SethHibpshman/EWU-ASME-SDC-2026-Robot/firmware/ASME_v2/README.txt

# ASME Coding Project Version 2.0

v2.0 utilizes the full 180degs that the servos offer. Previous version only got ~90degs of movement.
