SethHibpshman/EWU-ASME-SDC-2026-Robot/firmware/ASME_v3/README.txt

# ASME Coding Project Version 2.0

Adds ESC motor functionality. Signal on channel 3 on transmitter, D12 on the Arduino.
