SethHibpshman/EWU-ASME-SDC-2026-Robot/firmware/ASME_v8/README.txt

SW works for gripper shoulder, but turns too far.
gripper hand is always closed and doesnt change
