SethHibpshman/EWU-ASME-SDC-2026-Robot/assets/fig09-steering-radius.png

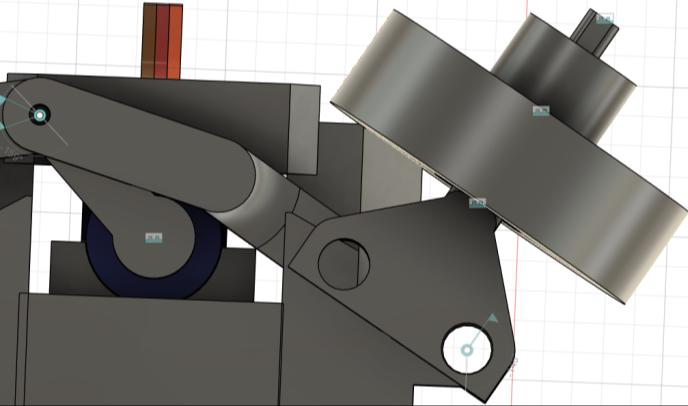
assets/fig09-steering-radius.png
