SethHibpshman/EWU-ASME-SDC-2026-Robot/hardware/PCB KiCAD/File Exports/ASME-eFest.step

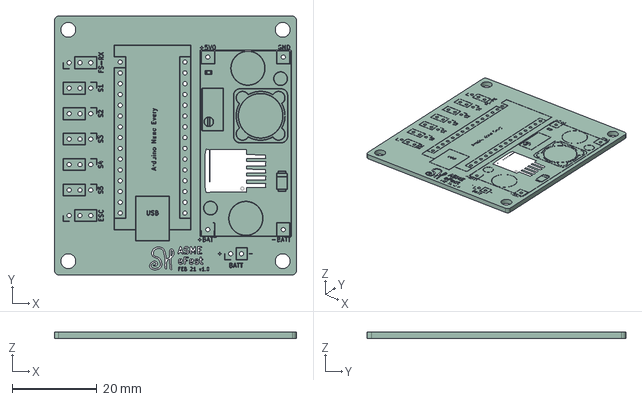
[picture p33: CAD file, 2026-10-21]
hardware/PCB KiCAD/File Exports/ASME-eFest.step
57.0 x 61.0 x 1.58 mm
ASME-eFest_silkscreen
ASME-eFest_PCB
