SethHibpshman/EWU-ASME-SDC-2026-Robot/(list of files, cad)

Other CAD files:
3D Models/Drive System/16T Bevel Gear.f3d
3D Models/Drive System/6 pack.f3d
3D Models/Drive System/ARMAMENT.f3d
3D Models/Drive System/Arm Servo Mount.f3z
3D Models/Drive System/Bearing Blocks (276-2016-001).f3d
3D Models/Drive System/Black Servo.f3d
3D Models/Drive System/Drive Motor Mount Base.f3d
3D Models/Drive System/Dumper Servo Mount.f3d
3D Models/Drive System/Final Final Assembly.f3z
3D Models/Drive System/Front Drive Assembly.f3z
3D Models/Drive System/Front Top Mount.f3d
3D Models/Drive System/Front Wheel.f3d
3D Models/Drive System/Front bushing.f3d
3D Models/Drive System/Large 5 pack.f3d
3D Models/Drive System/Left Control Arm.f3d
3D Models/Drive System/Left Fake Cross Base Beam.f3d
3D Models/Drive System/Old Dumping Container.f3d
3D Models/Drive System/Rear Frame Mount.f3d
3D Models/Drive System/Right Fake Cross Beam.f3d
3D Models/Drive System/SECOND ARMAMENT.f3d
3D Models/Drive System/Servo Futaba S3003 v6.f3d
3D Models/Drive System/Static Arm.f3d
3D Models/Drive System/Wheel.f3d
3D Models/Drive System/pcb_2x8.f3d
3D Models/Electronics/Amazing Wheel Assembly.f3z
3D Models/Electronics/Brushed Drive Motor.f3d
3D Models/Electronics/MicroServo horn.f3d
3D Models/Electronics/PCB Housing.f3d
3D Models/Electronics/TT Motor Dual Shaft.f3d
3D Models/Electronics/Yellow Motor Mount.f3d
3D Models/Electronics/Yellow Motor Wheel.f3d
hardware/3D Models/Drive System/32T Bevel Gear.f3d
hardware/3D Models/Drive System/Big black super servo.f3d
hardware/3D Models/Drive System/Biggest 5 pack ever.f3d
hardware/3D Models/Drive System/Black servo horn.f3d
hardware/3D Models/Drive System/Controller Mounting.f3d
hardware/3D Models/Drive System/D shaft to square shaft adapter.f3d
hardware/3D Models/Drive System/Drive Motor Mount Base Top Half.f3d
hardware/3D Models/Drive System/Dumper Small.f3d
hardware/3D Models/Drive System/Dumper.f3d
hardware/3D Models/Drive System/Dumping Container.f3d
hardware/3D Models/Drive System/Dumping Shaft.f3d
hardware/3D Models/Drive System/Final frame.f3z
hardware/3D Models/Drive System/Frame top with arm mount.f3z
hardware/3D Models/Drive System/Frame.f3z
hardware/3D Models/Drive System/Front Right Frame Mount.f3d
hardware/3D Models/Drive System/Front steering axle.f3d
hardware/3D Models/Drive System/Front wheels.f3z
hardware/3D Models/Drive System/Left Cross Base Beam.f3d
hardware/3D Models/Drive System/Little PCB Mount.f3z
hardware/3D Models/Drive System/Main Bottom Side Assembly.f3z
hardware/3D Models/Drive System/New Final Cross beam.f3d
hardware/3D Models/Drive System/Really Good Dumper.f3d
hardware/3D Models/Drive System/Rear Drive Shaft.f3d
hardware/3D Models/Drive System/Rear Drive System Assembly.f3z
hardware/3D Models/Drive System/Rear Top Mount.f3d
hardware/3D Models/Drive System/Repeat_Compact.f3d
hardware/3D Models/Drive System/Right Control Arm.f3d
hardware/3D Models/Drive System/Right Cross Beam.f3d
hardware/3D Models/Drive System/Shaft Collar.f3d
hardware/3D Models/Drive System/Single Arm.f3d
hardware/3D Models/Drive System/Small bevel coupling.f3d
hardware/3D Models/Drive System/Square Shaft.f3d
hardware/3D Models/Drive System/Wheel Assembly Front Side.f3z
hardware/3D Models/Drive System/Wheel mount.f3d
hardware/3D Models/Dumping and Container/Servo Adapter.f3d
hardware/3D Models/Dumping and Container/Servo Mounting.f3d
hardware/3D Models/Electronics/4_Battery_Block.f3d
hardware/3D Models/Electronics/Arduino UNO R3.f3d
hardware/3D Models/Electronics/AwesomePCB.f3d
hardware/3D Models/Electronics/Base Robot arm Servo mount.f3d
hardware/3D Models/Electronics/Bracket For Yellow Motors.f3d
hardware/3D Models/Electronics/Grabber Arm V2 Assembly.f3d
hardware/3D Models/Electronics/Servo-Motor.f3z
hardware/3D Models/Electronics/TT Motor Mount Hall Sensor.f3d
hardware/3D Models/Electronics/Test Cubes.f3d
