SethHibpshman/EWU-ASME-SDC-2026-Robot/firmware/10CHReceiver_Debug/README.txt

# ASME Project - Debug

This code works as intended, but also prints out the channel value in the serial terminal when at 115200 baud.
