SethHibpshman/EWU-ASME-SDC-2026-Robot/hardware/PCB KiCAD/ASME-eFest.kicad_pcb

## KiCad design hardware/PCB KiCAD/ASME-eFest.kicad_pcb (2026-10-21)

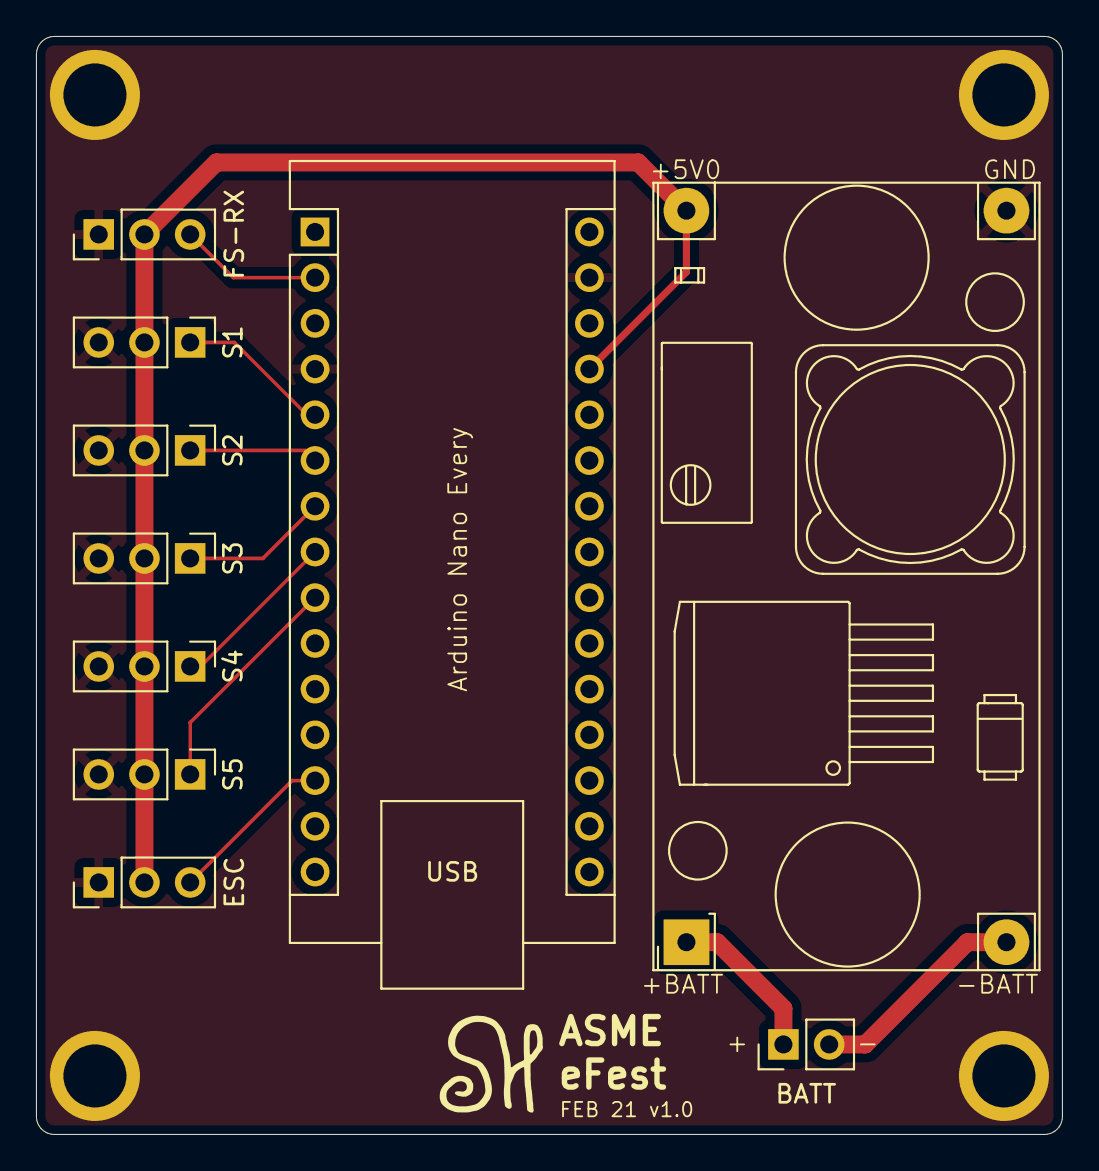
[picture p34: board ASME-eFest.kicad_pcb from above]

Board: 2 copper layers, 57.0 x 61.0 mm, 10 parts (0 on the bottom side), 11 nets.

Parts:
A2: Arduino_Nano_Every; Arduino_Nano
BATT: PinHeader_1x02_P2.54mm_Vertical
ESC: ESC; PinHeader_1x03_P2.54mm_Vertical
FS-RX: PinHeader_1x03_P2.54mm_Vertical
S1, S2, S3, S4, S5: Motor_Servo; PinHeader_1x03_P2.54mm_Vertical
U1: DCDC_StepDown; YAAJ_DCDC_StepDown_LM2596

Connections:
+5V: A2.27 (+5V), ESC.2 (S_VCC), FS-RX.1 (VCC), S1.2 (+), S2.2 (+), S3.2 (+), S4.2 (+), S5.2 (+), U1.4 (Vout)
+BATT: BATT.1, U1.1 (Vin)
-BATT: BATT.2, U1.2 (GND)
GND: A2.4 (GND), A2.29 (GND), ESC.1 (S_GND), FS-RX.2 (GND), S1.3 (-), S2.3 (-), S3.3 (-), S4.3 (-), S5.3 (-), U1.3 (GND)
unnamed: A2.5 (D2), S1.1 (PWM)
unnamed: A2.6 (D3), S2.1 (PWM)
unnamed: A2.7 (D4), S3.1 (PWM)
unnamed: A2.8 (D5), S4.1 (PWM)
unnamed: A2.9 (D6), S5.1 (PWM)
unnamed: A2.13 (D10), ESC.3 (Signal)
unnamed: A2.2 (RX1), FS-RX.3 (IBUS_TX)
